Lickitysplitted/fan-rf-bridge/case/wESP32_Case_Top_Magnetic.stl

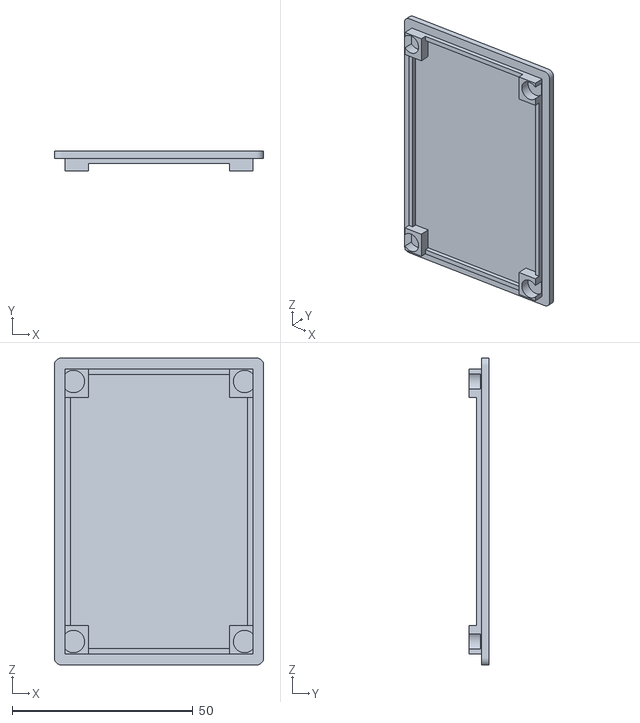
[picture p1: CAD file, 2026-10-23]
case/wESP32_Case_Top_Magnetic.stl
58.0 x 5.50 x 85.0
