Lickitysplitted/fan-rf-bridge/case/wESP32_Case_Base_Tall_HAT.stl

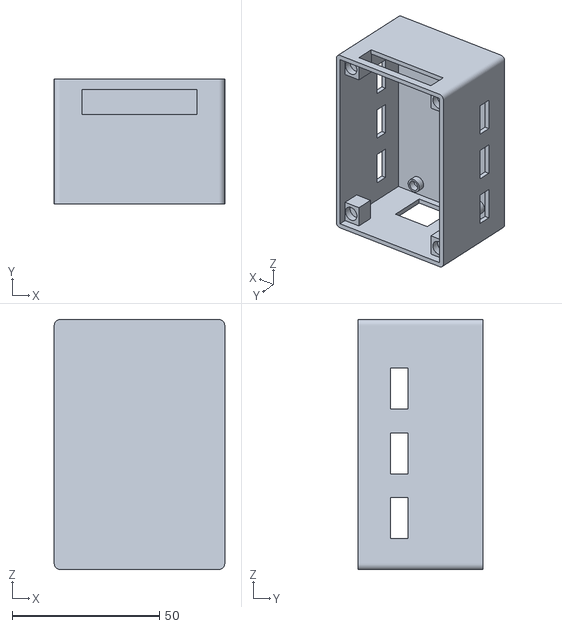
[picture p2: CAD file, 2026-10-23]
case/wESP32_Case_Base_Tall_HAT.stl
58.0 x 42.5 x 85.0
