Lickitysplitted/fan-rf-bridge/pcb/fan-hat.kicad_pcb

## KiCad design pcb/fan-hat.kicad_pcb (2026-10-23)

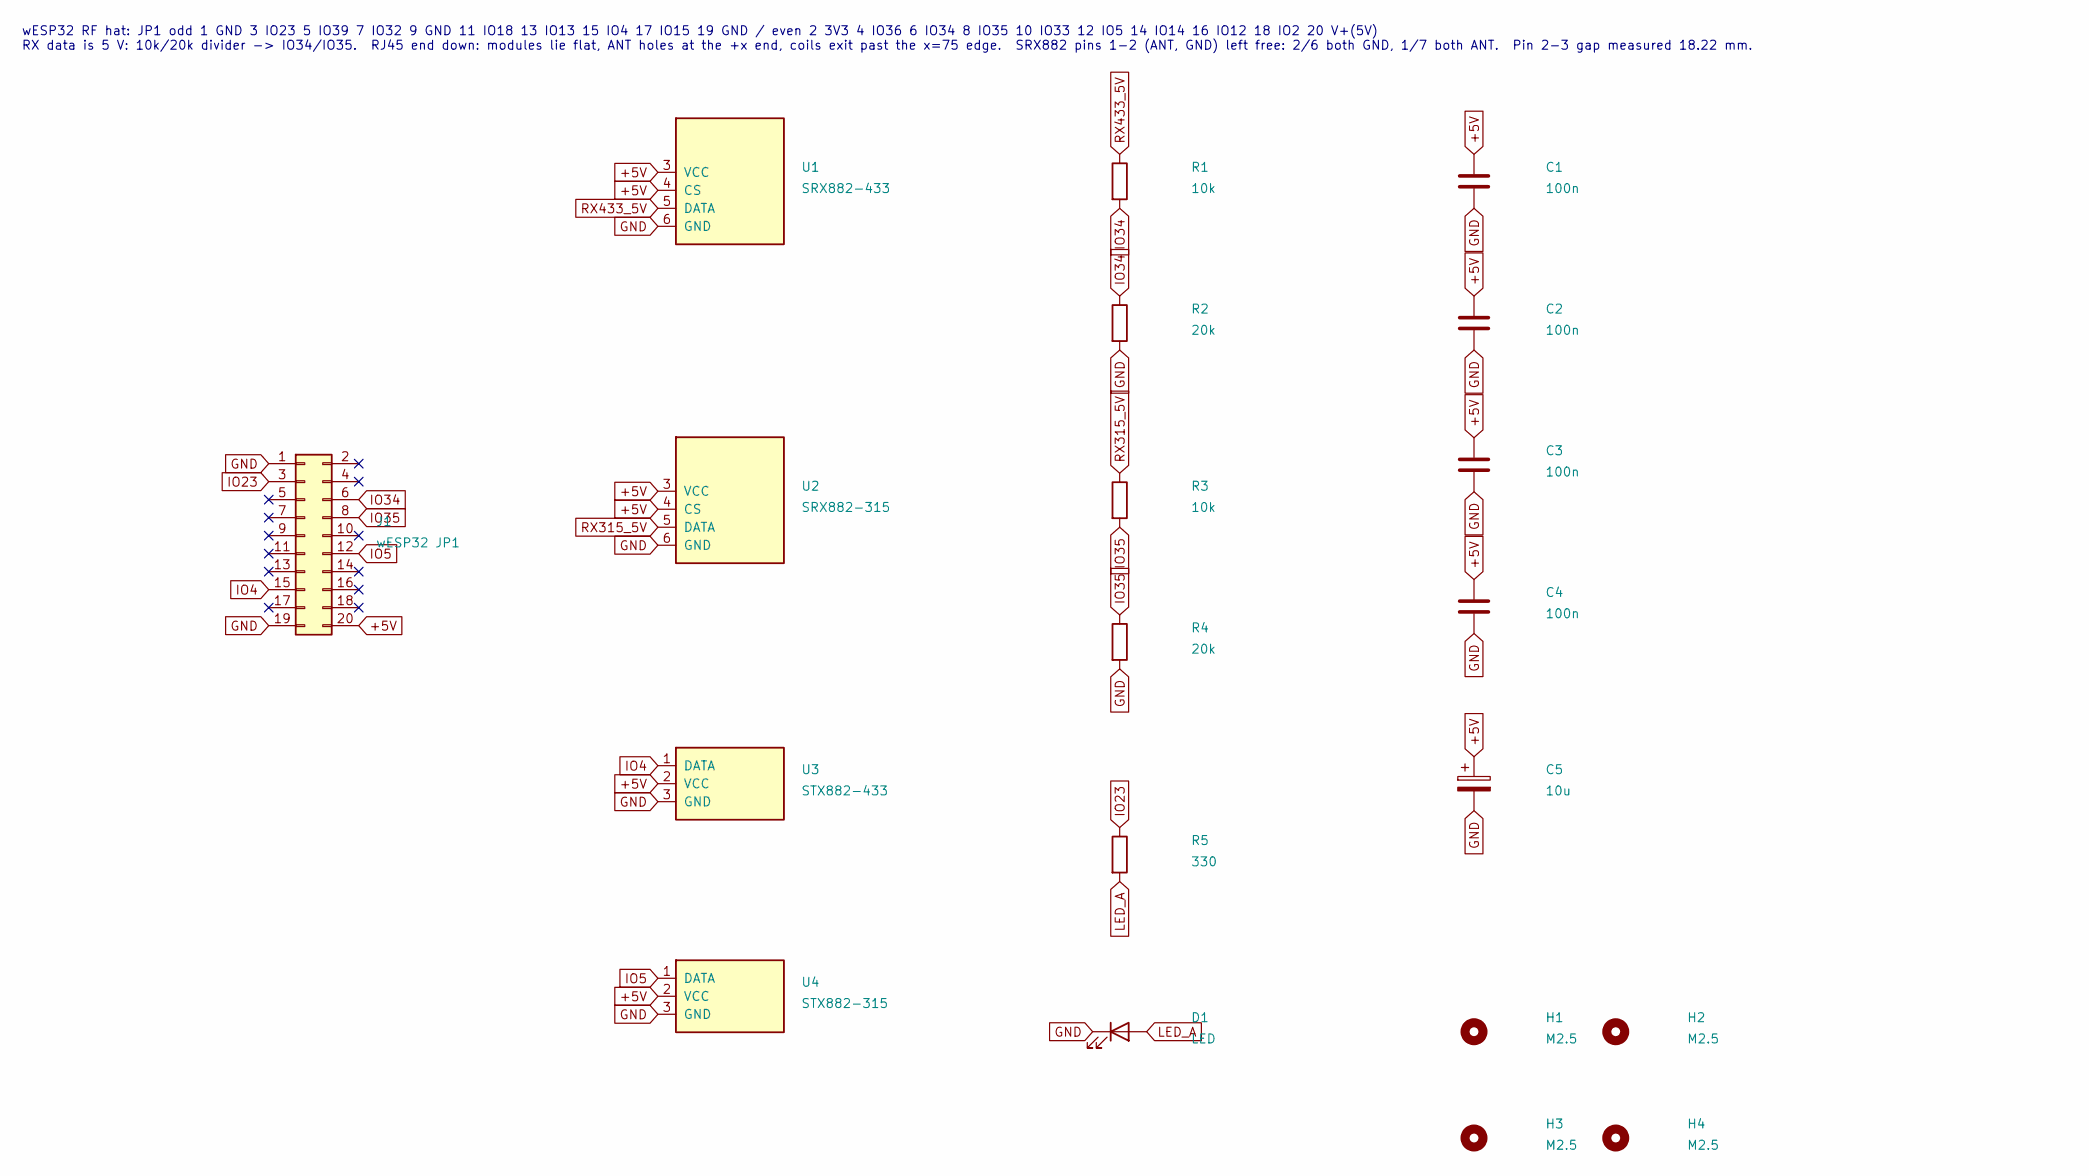
[picture p3: schematic fan-hat.kicad_sch]

Parts:
C1, C2, C3, C4: 100n; C_Disc_D5.0mm_W2.5mm_P2.50mm
C5: 10u; CP_Radial_D5.0mm_P2.00mm
D1: LED; LED_D3.0mm
H1, H2, H3, H4: M2.5; MountingHole_3.2mm_M3
J1: wESP32 JP1; PinSocket_2x10_P2.54mm_Vertical
R1, R3: 10k; R_Axial_DIN0207_L6.3mm_D2.5mm_P7.62mm_Horizontal
R2, R4: 20k; R_Axial_DIN0207_L6.3mm_D2.5mm_P7.62mm_Horizontal
R5: 330; R_Axial_DIN0207_L6.3mm_D2.5mm_P7.62mm_Horizontal
U1: SRX882-433; SRX882_Socket
U2: SRX882-315; SRX882_Socket_BodyDown
U3: STX882-433; PinSocket_1x03_P2.54mm_Vertical
U4: STX882-315; PinSocket_1x03_P2.54mm_Vertical

Connections:
+5V: C1.1, C2.1, C3.1, C4.1, C5.1, J1.20, U1.3 (VCC), U1.4 (CS), U2.3 (VCC), U2.4 (CS), U3.2 (VCC), U4.2 (VCC)
GND: C1.2, C2.2, C3.2, C4.2, C5.2, D1.1 (K), J1.1, J1.19, R2.2, R4.2, U1.6 (GND), U2.6 (GND), U3.3 (GND), U4.3 (GND)
IO4: J1.15, U3.1 (DATA)
IO5: J1.12, U4.1 (DATA)
IO23: J1.3, R5.1
IO34: J1.6, R1.2, R2.1
IO35: J1.8, R3.2, R4.1
LED_A: D1.2 (A), R5.2
RX315_5V: R3.1, U2.5 (DATA)
RX433_5V: R1.1, U1.5 (DATA)

Notes on the sheet:
wESP32 RF hat: JP1 odd 1 GND 3 IO23 5 IO39 7 IO32 9 GND 11 IO18 13 IO13 15 IO4 17 IO15 19 GND / even 2 3V3 4 IO36 6 IO34 8 IO35 10 IO33 12 IO5 14 IO14 16 IO12 18 IO2 20 V+(5V) RX data is 5 V: 10k/20k divider -> IO34/IO35. RJ45 end down: modules lie flat, ANT holes at the +x end, coils exit past the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

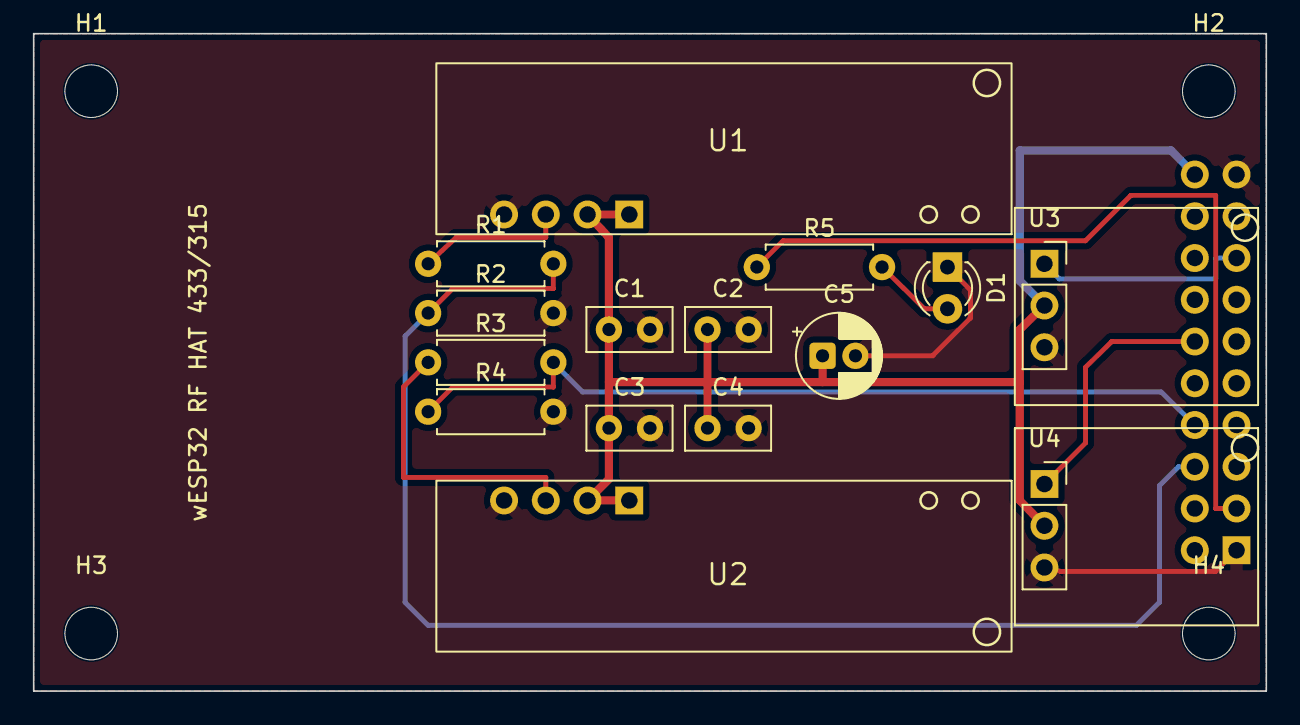
[picture p4: board fan-hat.kicad_pcb from above]

Board: 2 copper layers, 75.0 x 40.0 mm, 20 parts (1 on the bottom side), 10 nets.
