Lickitysplitted/fan-rf-bridge/(commit log)

2026-10-23 Initial commit: ESPHome fan RF bridge, KiCad HAT, printable case
    ESPHome config for a wESP32 driving 433/315 MHz STX882/SRX882 radios with
    two-way remote tracking for FT0317A and FA0188A ceiling fans, plus the rtl_433
    captures the codes came from, the generated KiCad HAT project and Gerbers, and
    a CC BY-NC-SA remix of the wESP32 case.
    Claude-Session: https://claude.ai/code/session_01X2f33Udgh1wGMtBdSTQaps
    [fan-hat.kicad_pcb, fan-hat.kicad_sch, wESP32_Case_Base_Tall_HAT.stl, wESP32_Case_Top_Magnetic.stl]
2026-11-02 README: capturing remotes and adding devices
    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
2026-11-02 Add MIT license (case/ stays CC BY-NC-SA)
    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
2026-11-02 MIT LICENSE without the case/ note (kept in README) so GitHub detects it; README: other RF device types
    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
